cbr/EQ-lips-schematic/bom.ods

Sheet: BOM other
Reference | Details | Number
LCD screen (122x32 based on NJU6450) |  | 2
Jack 6.35 mono female |  | 2
Footswitch DPDT momentary |  | 2
Footswitch 3PDT |  | 1
Led |  | 1
DC Jack 2.1 mm |  | 1
Rotary Encoder ALPS EC12 |  | 1
R (for LED) | 470 ohms | 1
Enclosure Hammond 1590D |  | 1
Wire

Sheet: BOM PCB raw
ref | value | sheet path | location
C_EQ_1 | 10uF | /eq/ | D2)
C_EQ_3 | 10uF | /eq/ | D3)
C_EQ_4 | 470pF | /eq/ | D4)
C_EQ_6 | 3.3uF | /eq/ | A1)
C_EQ_7 | 47nF | /eq/ | A1)
C_EQ_8 | 3.3uF | /eq/ | C1)
C_EQ_9 | 47nF | /eq/ | C1)
C_EQ_10 | 680nF | /eq/ | A2)
C_EQ_11 | 15nF | /eq/ | A2)
C_EQ_12 | 330nF | /eq/ | C2)
C_EQ_13 | 15nF | /eq/ | C2)
C_EQ_14 | 100nF | /eq/ | A3)
C_EQ_15 | 680pF | /eq/ | A3)
C_EQ_16 | 220n | /eq/ | C3)
C_EQ_17 | 3.3nF | /eq/ | C3)
C_EQ_18 | 100nF | /eq/ | A4)
C_EQ_19 | 1.8nF | /eq/ | A4)
C_EQ_20 | 47nF | /eq/ | C4)
C_EQ_21 | 120pF | /eq/ | C4)
C_EQ_22 | 22nF | /eq/ | A6)
C_EQ_23 | 470pF | /eq/ | A6)
C_EQ_24 | 10nF | /eq/ | C6)
C_EQ_25 | 15pF | /eq/ | C6)
C_EQ_26 | 820pF | /eq/ | E5)
C_EQ_27 | 10uF | /eq/ | D5)
C_EQ_B6 | 3.3uF | /eq/ | A1)
C_EQ_B7 | 68nF | /eq/ | A1)
C_EQ_B8 | 6.8nF | /eq/ | C1)
C_EQ_B9 | 10nF | /eq/ | C1)
C_EQ_B10 | 1uF | /eq/ | A2)
C_EQ_B11 | 15nF | /eq/ | A2)
C_EQ_B12 | 470nF | /eq/ | C2)
C_EQ_B13 | DNP | /eq/ | C2)
C_EQ_B14 | 330nF | /eq/ | A3)
C_EQ_B15 | 6.8nF | /eq/ | A3)
C_EQ_B16 | DNP | /eq/ | C3)
C_EQ_B17 | 470pF | /eq/ | C3)
C_EQ_B18 | 6.8nF | /eq/ | A4)
C_EQ_B19 | 68pF | /eq/ | A4)
C_EQ_B20 | 6.8nF | /eq/ | C4)
C_EQ_B21 | 820pF | /eq/ | C4)
C_EQ_B22 | 4.7nF | /eq/ | A5)
C_EQ_B23 | DNP | /eq/ | A5)
C_EQ_B24 | 3.3nF | /eq/ | C5)
C_EQ_B25 | 220pF | /eq/ | C5)
C_PW_1 | 10uF | /eq_alim/ | A1)
C_PW_2 | 10uF | /eq_alim/ | B2)
C_PW_3 | 100uF | /eq_alim/ | A3)
C_PW_4 | 10uF | /eq_alim/ | A4)
D_PIC_1 | DIODE | /pic/ | A2)
D_PW_1 | DIODE | /eq_alim/ | A3)
IC_PIC_1 | PIC16F886 | /pic/ | B2)
K_LCD_1 | CONN_JMP_1 | /lcd/ | A1)
P_ENC_1 | CONN_5 | /encoder/ | A2)
P_EQ_1 | CONN_2 | /eq/ | D1)
P_EQ_2 | CONN_2 | /eq/ | D6)
P_LCD_1 | CONN_9 | /lcd/ | A2)
P_LCD_2 | CONN_9 | /lcd/ | A2)
P_PIC_1 | CONN_6 | /pic/ | A3)
P_PIC_2 | CONN_4 | /pic/ | B4)
P_PW_1 | CONN_2 | /eq_alim/ | A1)
R_ENC_1 | 10k | /encoder/ | A1)
R_ENC_2 | 10k | /encoder/ | A1)
R_ENC_3 | 10k | /encoder/ | A2)
R_EQ_1 | 10k | /eq/ | D2)
R_EQ_2 | 3300 | /eq/ | D2)
R_EQ_3 | 150 | /eq/ | E2)
R_EQ_4 | 100k | /eq/ | D3)
R_EQ_5 | 3300 | /eq/ | D4)
R_EQ_6 | 470 | /eq/ | A1)
R_EQ_7 | 68k | /eq/ | B1)
R_EQ_8 | 470 | /eq/ | C1)
R_EQ_9 | 68k | /eq/ | D1)
R_EQ_10 | 470 | /eq/ | A3)
R_EQ_11 | 68k | /eq/ | B2)
R_EQ_12 | 470 | /eq/ | C3)
R_EQ_13 | 68k | /eq/ | D2)
R_EQ_14 | 470 | /eq/ | A4)
R_EQ_15 | 68k | /eq/ | B3)
R_EQ_16 | 470 | /eq/ | C4)
R_EQ_17 | 68k | /eq/ | D3)
R_EQ_18 | 470 | /eq/ | A5)
R_EQ_19 | 68k | /eq/ | B4)
R_EQ_20 | 470 | /eq/ | C5)
R_EQ_21 | 68k | /eq/ | D4)
R_EQ_22 | 470 | /eq/ | A6)
R_EQ_23 | 68k | /eq/ | B6)
R_EQ_24 | 470 | /eq/ | C6)
R_EQ_25 | 68k | /eq/ | D6)
R_EQ_26 | 3300 | /eq/ | E5)
R_EQ_27 | 10k | /eq/ | D5)
R_EQ_28 | 100 | /eq/ | D5)
R_EQ_29 | 3300 | /eq/
R_EQ_30 | 470k | /eq/ | D1)
RV_LCD_1 | 10k | /lcd/ | A1)
U_EQ_1A | MCP42XXX | /eq/ | A1)
U_EQ_1B | MCP42XXX | /eq/ | C1)
U_EQ_2A | MCP42XXX | /eq/ | A2)
U_EQ_2B | MCP42XXX | /eq/ | C2)
U_EQ_3A | MCP42XXX | /eq/ | A3)
U_EQ_3B | MCP42XXX | /eq/ | C3)
U_EQ_4A | MCP42XXX | /eq/ | A4)
U_EQ_4B | MCP42XXX | /eq/ | C4)
U_EQ_5A | MCP42XXX | /eq/ | A6)
U_EQ_5B | MCP42XXX | /eq/ | C6)
U_EQ_6A | MCP42010 | /eq/ | E3)
U_EQ_6B | MCP42010 | /eq/ | B7)
U_EQ_8A | TL074 | /eq/ | B1)
U_EQ_8B | TL074 | /eq/ | D1)
U_EQ_8C | TL074 | /eq/ | B3)
U_EQ_8D | TL074 | /eq/ | D3)
U_EQ_9A | TL074 | /eq/ | B4)
U_EQ_9B | TL074 | /eq/ | D4)
U_EQ_9C | TL074 | /eq/ | B5)
U_EQ_9D | TL074 | /eq/ | D5)
U_EQ_10A | TL074 | /eq/ | B6)
U_EQ_10B | TL074 | /eq/ | D6)
U_EQ_10C | TL074 | /eq/ | D2)
U_EQ_10D | TL074 | /eq/ | D5)
U_EQ_11 | TL071 | /eq/ | D1)
U_PW_1 | MAX1044 | /eq_alim/ | A2)
U_PW_2 | LM7805 | /eq_alim/ | A3)
W_EQ_1 | TEST | /eq/ | D2)
W_EQ_3 | TEST | /eq/ | E4)
W_EQ_4 | TEST | /eq/ | D6)
W_PW_M9 | TEST | /eq_alim/ | A2)
W_PW_P5 | TEST | /eq_alim/ | A4)
W_PW_P9 | TEST | /eq_alim/ | A3)

Sheet: BOM PCB group
ref | value | sheet path | Details | Number
C | 1uF | /eq/ | MKT Std | 1
C | 120pF | /eq/ | Panasonic ECQ-P | 1
C | 3.3uF | /eq/ | Panasonic FC 100V | 3
C | 10uF | /eq/ | Panasonic FC 100V | 6
C | 100uF | /eq_alim/ | Panasonic FC 63V | 1
C | 680nF | /eq/ | Panasonic SMF | 1
C | 15pF | /eq/ | Silver Mica Std | 1
C | 820pF | /eq/ | Silver Mica Std | 2
C | 68pF | /eq/ | WIMA FKP2 Std | 1
C | 220pF | /eq/ | WIMA FKP2 Std | 1
C | 470pF | /eq/ | WIMA FKP2 Std | 3
C | 680pF | /eq/ | WIMA FKP2 Std | 1
C | 1.8nF | /eq/ | Xicon Greenies | 1
C | 3.3nF | /eq/ | Xicon Greenies | 2
C | 4.7nF | /eq/ | Xicon Greenies | 1
C | 6.8nF | /eq/ | Xicon Greenies | 4
C | 10nF | /eq/ | Xicon Greenies | 2
C | 15nF | /eq/ | Xicon Greenies | 3
C | 22nF | /eq/ | Xicon Greenies | 1
C | 47nF | /eq/ | Xicon Greenies | 3
C | 68nF | /eq/ | Xicon Greenies | 1
C | 100nF | /eq/ | Xicon Greenies | 2
C | 220nF | /eq/ | Xicon Greenies | 1
C | 330nF | /eq/ | Xicon Greenies | 2
C | 470nF | /eq/ | Xicon Greenies | 1
Diode | DIODE | /pic/ |  | 2
DIL mâle | 2 pins | /eq/ |  | 10
DIL mâle | 3 pins | /lcd/ |  | 1
DIL mâle | 4 pins | /pic/ |  | 1
DIL mâle | 5 pins | /encoder/ |  | 1
DIL mâle | 6 pins | /pic/ |  | 1
DIL mâle | 9 pins | /lcd/ |  | 2
Jumper |  |  |  | 8
PIC16F886 |  | /pic/ |  | 1
R | 100 | /eq/ |  | 1
R | 150 | /eq/ |  | 1
R | 470 | /eq/ |  | 10
R | 3300 | /eq/ |  | 4
R | 1.2k | /eq/ |  | 0
R | 10k | /encoder/ |  | 6
R | 68k | /eq/ |  | 10
R | 100k | /eq/ |  | 1
R | 470k | /eq/ |  | 1
SIL femelle | 32 pins |  |  | 4
Socket IC | 14 pins |  |  | 3
NumPot | MCP42010 | /eq/ |  | 6
AOPx4 | TL074 | /eq/ |  | 3
MAX1044 | MAX1044 | /eq_alim/ |  | 1
LM78 | LM7805 | /eq_alim/ |  | 1
AOPx1 | TL071 | /eq/ |  | 1
