cbr/EQ-lips-schematic/encoder.sch

## KiCad design encoder.sch (2010-10-25)

Schematic: encoder.sch

Parts:
P_ENC_1: CONN_5
R_ENC_1, R_ENC_2, R_ENC_3: 10k
