cbr/EQ-lips-schematic/eq.sch

## KiCad design eq.sch (2010-10-25)

Schematic: eq.sch

Parts:
C_EQ_1, C_EQ_3: 10u
C_EQ_4: 470 pF
C_EQ_6, C_EQ_8: 3.3uF
C_EQ_7, C_EQ_9, C_EQ_20: 47nF
C_EQ_10: 680nF
C_EQ_11, C_EQ_13: 15nF
C_EQ_12: 330nF
C_EQ_14, C_EQ_18: 100nF
C_EQ_15: 680pF
C_EQ_16: 220n
C_EQ_17: 3.3nF
C_EQ_19: 1.8nF
C_EQ_21: 120pF
C_EQ_22: 22nF
C_EQ_23: 470pF
C_EQ_24: 10nF
C_EQ_25: 15pF
C_EQ_26: 820pF
C_EQ_27: 10uF
C_EQ_B6: 3.3uF
C_EQ_B7: 68nF
C_EQ_B8, C_EQ_B15, C_EQ_B18, C_EQ_B20: 6.8nF
C_EQ_B9: 10nF
C_EQ_B10: 1uF
C_EQ_B11: 15nF
C_EQ_B12: 470nF
C_EQ_B13, C_EQ_B16, C_EQ_B23: DNP
C_EQ_B14: 330nF
C_EQ_B17: 470pF
C_EQ_B19: 68pF
C_EQ_B21: 820pF
C_EQ_B22: 4.7nF
C_EQ_B24: 3.3nF
C_EQ_B25: 220pF
P_EQ_1, P_EQ_2: CONN_2
R_EQ_1, R_EQ_27: 10k
R_EQ_2, R_EQ_5, R_EQ_26, R_EQ_29: 3300
R_EQ_3, R_EQ_6, R_EQ_8, R_EQ_10, R_EQ_12, R_EQ_14, R_EQ_16, R_EQ_18, R_EQ_20, R_EQ_22, R_EQ_24: 470
R_EQ_4: 100k
R_EQ_7, R_EQ_9, R_EQ_11, R_EQ_13, R_EQ_15, R_EQ_17, R_EQ_19, R_EQ_21, R_EQ_23, R_EQ_25: 68k
R_EQ_28: 100
R_EQ_30: 470k
U_EQ_1, U_EQ_2, U_EQ_3, U_EQ_4, U_EQ_5: MCP42XXX
U_EQ_6: MCP42010
U_EQ_8, U_EQ_9, U_EQ_10: TL074
U_EQ_11: TL071
W_EQ_1, W_EQ_3, W_EQ_4: TEST

Notes on the sheet:
R_EQ_5 and R_EQ_26 have to be equal!
MCP42XXX -> MCP42010 = 10KOhms
Active low-pass 64697 Hz
High pass 1,59 Hz
low pass 102 kHz
High pass 0.15 Hz
High pass 1.59 Hz
16 kHz
8 kHz
4 kHz
2 kHz
1 kHz
500 Hz
250 Hz
125 Hz
64 Hz
32 Hz
