cbr/EQ-lips-schematic/eq_alim.sch

## KiCad design eq_alim.sch (2010-10-25)

Schematic: eq_alim.sch

Parts:
C_PW_1, C_PW_2, C_PW_4: 10uF
C_PW_3: 100uF
D_PW_1: DIODE
P_PW_1: CONN_2
U_PW_1: MAX1044
U_PW_2: LM7805
W_PW_M9: TEST
W_PW_P5, W_PW_P9: TEST

Notes on the sheet:
+9V to +5V: http://stuff.nekhbet.ro/2006/06/18/how-to-build-a-5v-regulator-using-78l05-7805.html
+9V to -9V: http://www.geofex.com/circuits/+9_to_-9.htm
