cbr/EQ-lips-schematic/extension.sch

## KiCad design extension.sch (2010-10-24)

Schematic: extension.sch

Parts:
P1, P2: CONN_2
P_GROUND_1: CONN_1
R1: 470k
U1: TL071
