cbr/EQ-lips-schematic/lcd.sch

## KiCad design lcd.sch (2010-10-25)

Schematic: lcd.sch

Parts:
K_LCD_1: CONN_JMP_1
P_LCD_1, P_LCD_2: CONN_9
RV_LCD_1: 10k

Notes on the sheet:
Populate only R_LCD_1 or R_LCD_2
