cbr/EQ-lips-schematic/pic.sch

## KiCad design pic.sch (2010-10-25)

Schematic: pic.sch

Parts:
D_PIC_1: DIODE
IC_PIC_1: PIC16F886; microchip-DIL28-6
P_PIC_1: CONN_6
P_PIC_2: CONN_4
