cbr/EQ-lips-schematic/(commit log)

2010-10-19 Fix error met on 1.0.0 version (schema and pcb)
    [encoder.sch, eq.sch, eq_alim.sch, eq_prog.brd, eq_prog.sch, lcd.sch, pic.sch]
2010-10-24 Extension used on 1.0.0 version to add input buffer.
    [extension.brd, extension.sch]
2010-10-24 Change version annotation on PCB
    [eq_prog.brd]
2010-10-24 Add resistance to extension
    [extension.brd, extension.sch]
2010-10-24 Rename project
    [eqlips.brd, eqlips.sch]
2010-10-24 Update schematics notes
    [encoder.sch, eq.sch, eq_alim.sch, eqlips.sch, lcd.sch, pic.sch]
2010-10-25 Add external components and footprints as a submodule
2010-10-25 Use kicad_lib submodule in project
    [encoder.sch, eq.sch, eq_alim.sch, eqlips.sch, lcd.sch, pic.sch]
2010-10-27 Add licence on PCB
    [eqlips.brd]
2010-11-02 Add BOM
    [bom.ods]
2010-11-02 Fix bom.ods link
2010-11-02 Add info about LCD screen
    [bom.ods]
